ludobouan/following-webcam/README.md

# Following Webcam

Uses opencv to detect faces and oriente a webcam so that the face is always in the middle of the frame. Supports multiple faces. Uses an arduino and two servo motors.

[The report](https://github.com/ludobouan/following-webcam/blob/master/Me%CC%81moire.pdf) is available in french.
