ludobouan/following-webcam/(commit log)

2015-04-25 Traduction des commentaires
2015-04-28 add code arduino
2015-04-28 code arduino comments
